marcio-pessoa/x6/Documents/ArduinoMegaSensorShield3_Fronte.jpg

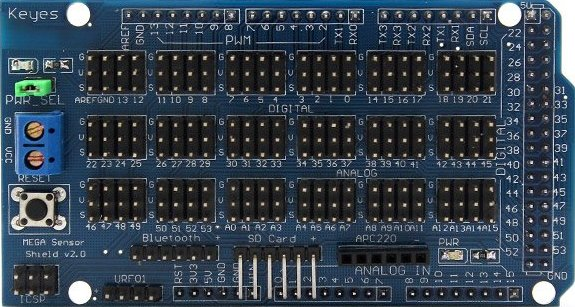
Documents/ArduinoMegaSensorShield3_Fronte.jpg
