marcio-pessoa/x6/Documents/download.jpg

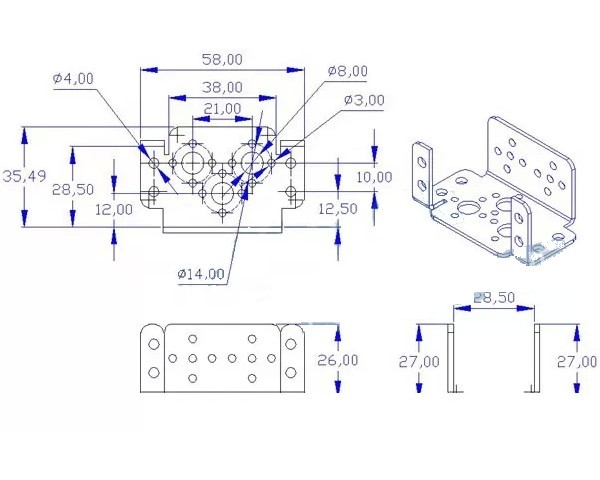
Documents/download.jpg
