marcio-pessoa/x6/Documents/Pictures/IMG_20151103_233049.jpg

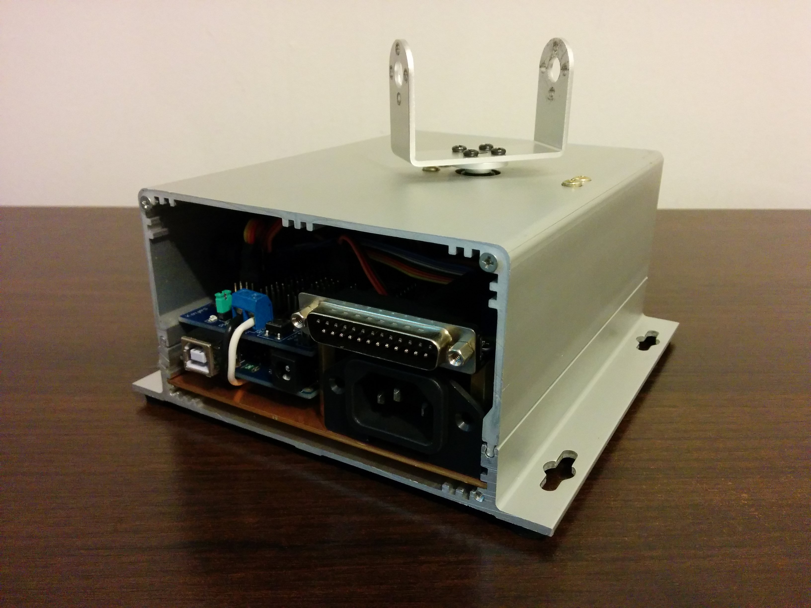
Documents/Pictures/IMG_20151103_233049.jpg
