marcio-pessoa/x6/Documents/Pictures/IMG_20151103_2321172.jpg

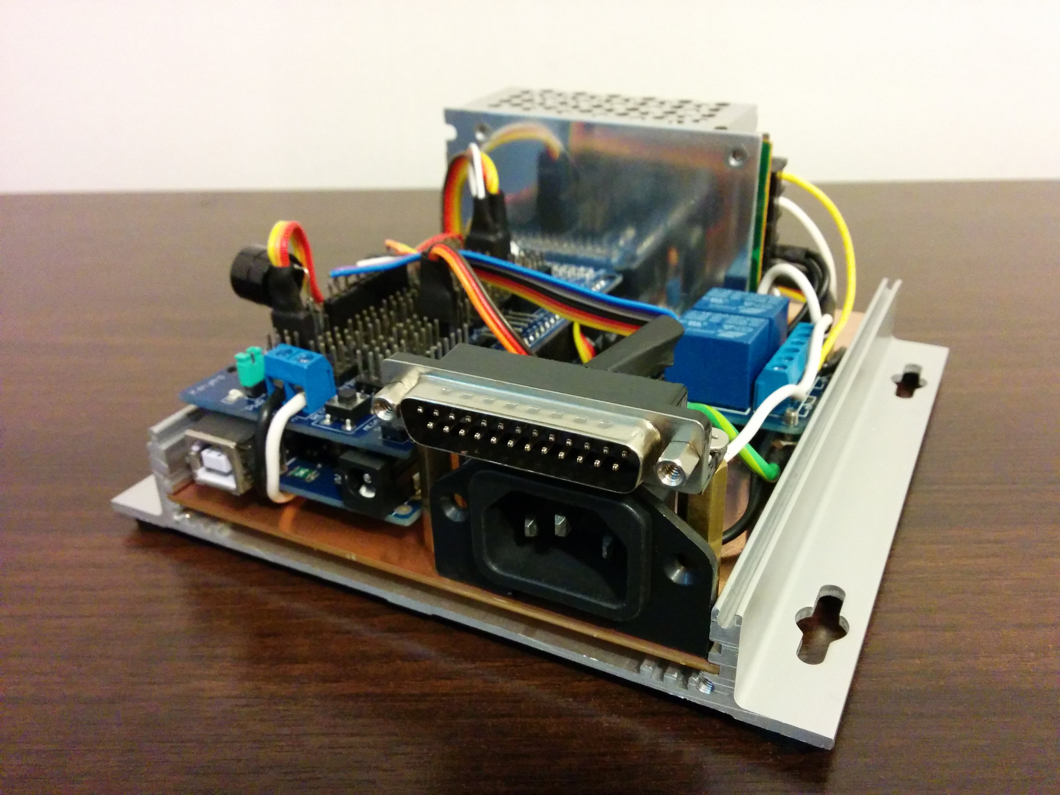
Documents/Pictures/IMG_20151103_2321172.jpg
