marcio-pessoa/x6/Documents/Pictures/x6-Mark-I-Live-demonstration.png

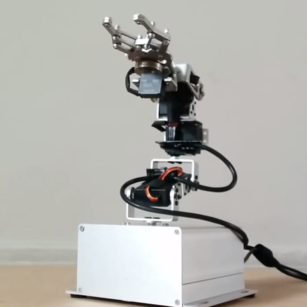
Documents/Pictures/x6-Mark-I-Live-demonstration.png
