marcio-pessoa/x6/Mechanics/Pictures/IMG_20181107_210936051.jpg

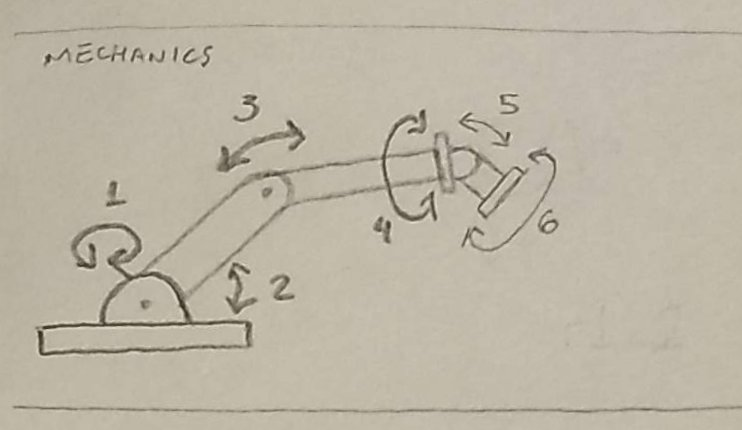
Mechanics/Pictures/IMG_20181107_210936051.jpg
