marcio-pessoa/x6/Mechanics/Pictures/IMG_20181107_211012699.jpg

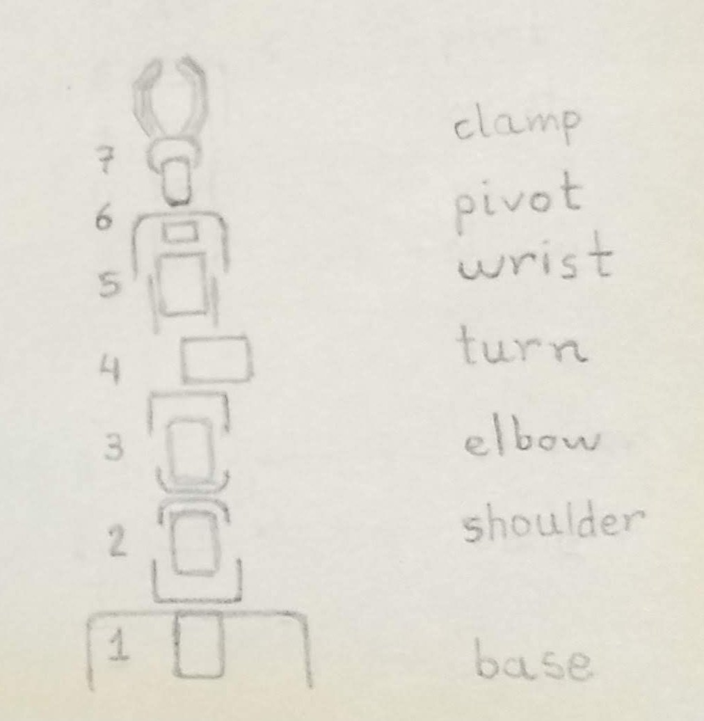
Mechanics/Pictures/IMG_20181107_211012699.jpg
