marcio-pessoa/x6/BOM.md

# BOM

x6 Mark I - Robotic Arm, Bill of materials

| Quant | Description | ID | Bought | Delivered  | Unit | Charge | Taxes | Cost |
|---|---|---|---|---|---|---|---|---|
| 1 | Case | 171177929049 | 2014-07-08 | 2014-08-29 | each |  22.50 | 00.00 |  00.00 |
| 1 | Arduino_Mega_2560 | 121021001026454322 | 2012-10-21 | 2013-mm-dd | each |  24.20 | 00.00 |  00.00 |

- 1 x 2DOF Aluminum Short U bracket & Multifunction Bracket for Robot Servo Joint DIY
  - Technical specification
    - URL: <http://www.dx.com/p/250674>
  - Buy
    - Date: 29/01/2014 02:34
    - Cost: USD 6.94
    - DX item ID: 140128001031940204
  - Delivery
    - Date: 2014-mm-dd
  - Install

- HJ S3315D 15kg Torque Metal gear Digital Servo for Robot Truck R/C Helicopter - Black
  - Technical specification
    - URL: <http://www.dx.com/p/193284>
  - Buy
    - Date: 29/01/2014 02:34
    - Cost: USD 11.97
    - DX item ID: 140128001031940204
  - Delivery
    - Date: 2014-mm-dd
  - Install

- Towerpro MG995 Metal Servo with Gears and Parts - Black
  - Technical specification
    - URL: <http://www.dx.com/p/20089>
  - Buy
    - Date: 18/07/2014 04:55
    - Cost: USD 7.71
    - DX item ID: 140717001098928788
  - Delivery
    - Date: 2014-mm-dd
  - Install

- EMAX ES3104 Metal Analog Servo with Gears and Parts - Black (4.8~6.0V)
  - Technical specification
    - URL: <http://www.dx.com/p/226837>
  - Buy
    - Date: 17/07/2014 04:22
    - Cost: USD 9.22
    - DX item ID: 140716001092373509
  - Delivery
    - Date: 2014-mm-dd
  - Install

- DIY PC817 2-CH 5V Relay Module w/ Optocoupler Extension Board - Blue
  - Technical specification
    - URL: <http://www.dx.com/p/290132>
  - Buy
    - Date: 22/04/2014 12:23
    - Cost: USD 3.70
    - DX item ID: 140422001040513986
  - Delivery
    - Date: 2014-mm-dd
  - Install

- 5V 3.8A Regulated Switching Power Supply - Silver
  - Technical specification
    - URL: <http://www.dx.com/p/145841>
  - Buy
    - Date: Tue, Oct 1, 2013 at 1:47 PM
    - Cost: USD 7.99
    - DX item ID: 131001001096463012
  - Delivery
    - Date: 2014-mm-dd
  - Install
- 3 x 2 Metal U Holders + 2 Mount Brackets for R/C Helicopter - Silver
  - Technical specification
    - URL: <http://www.dx.com/p/193069>
  - Buy
    - Date: Tue, Oct 1, 2013 at 3:45 PM
    - Cost: USD 9.45
    - DX item ID: 131001001097613313
  - Delivery
    - Date: 2014-mm-dd
  - Install
- DAGU VA2 Aluminum Alloy Robot Arm Clamp w/ Two Metal Gear Motors for Arduino - Silver White + Black-206374
  - Technical specification
    - URL: <http://www.dx.com/p/206374>
  - Buy
    - Date: Thu, Jul 4, 2013 at 2:35 PM
    - Cost: USD 52.10
    - DX item ID: 130704001062929240
  - Delivery
    - Date: 2013-mm-dd
  - Install
- 3 x HJ S3315D 15kg Torque Metal gear Digital Servo for Robot Truck R/C Helicopter - Black
  - Technical specification
    - URL: <http://www.dx.com/p/193284>
  - Buy
    - Date: Tue, Oct 1, 2013 at 3:45 PM
    - Cost: USD 29.01
    - DX item ID: 131001001097613313
  - Delivery
    - Date: 2014-mm-dd
  - Install

- MEGA Sensor Shield V2.0 Dedicated Sensor Expansion Board for Arduino
  - Technical specification
    - URL: <http://www.dx.com/p/120479>
  - Buy
    - Date: Fri, Oct 4, 2013 at 2:14 PM
    - Cost: USD 7.90
    - DX item ID: 131004001035335339
  - Delivery
    - Date: 2014-mm-dd
  - Install

- 2 Metal U Holders + 2 Round Servo Mount Brackets w/ Screws for R/C Helicopter - Silver-193069
  - Technical specification
    - URL: <http://www.dx.com/p/250674>
  - Buy
    - Date: Sun, Feb 23, 2014 at 8:38 PM
    - Cost: USD 4.12
    - DX item ID: 140223001030732822
  - Delivery
    - Date: 2014-mm-dd
  - Install

- 2DOF Aluminum Short U bracket & Multifunction Bracket for Robot Servo Joint DIY-250674
  - Technical specification
    - URL: <http://www.dx.com/p/250674>
  - Buy
    - Date: Tue, Jan 28, 2014 at 4:35 PM
    - Cost: USD 6.94
    - DX item ID: 140128001031940204
  - Delivery
    - Date: 2014-mm-dd
  - Install

- Stainless Steel threaded bar M4
  - Technical specification
    - URL: <http://www.ebay.com/itm/304-Stainless-Steel-Threaded-Rod-Bar-Studding-Allthread-M3-M4-M5-M6-M8-M10-M12-/321966375658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>
  - Buy
    - Date: Wed, Oct 26, 2016 at 7:36 AM
    - Cost: USD 2.43 (GBP 1.99)
    - eBay item ID: 321966375658
  - Delivery
    - Date: 2017-01-dd
  - Install

- Acorn nut M4
  - Technical specification
    - URL: <http://www.ebay.com/itm/Qty-10-M4-x-0-7mm-Pitch-Dome-Nuts-Acorn-Hex-Cap-Nuts-304-A2-Stainless-Steel-/182271690592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>
  - Buy
    - Date: Wed, Oct 26, 2016 at 7:41 AM
    - Cost: USD 1.62
    - eBay item ID: 182271690592
  - Delivery
    - Date: 2016-12-dd
  - Install

- Active Buzzer Long Continous Beep Speaker 5V
  - Technical specification
    - URL: <http://rover.ebay.com/rover/0/e11400.m1842.l5919/7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,ext=ext>
  - Buy
    - Date: Tue, Jan 5, 2016 at 6:23 AM
    - Cost: USD 0.99
    - eBay item ID: 361365119994
    - Delivery: 2016-mm-dd
  - Install

- Micro cooling fan DC 5V 0.1A 20mm
  - Technical specification
    - URL: <http://rover.ebay.com/rover/0/e11400.m1842.l5919/7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>
  - Buy
    - Date: Wed, Sep 7, 2016 at 8:19 PM
    - Cost: USD 1.6884054 (GBP 3.96 / 3)
    - eBay item ID: 271969912680
    - Delivery: 2016-mm-dd
  - Install

Currency: USD

International IOF: 6.38%
Domestic IOF: 0.38%

Total cost: $210.4784054
