marcio-pessoa/x6/(commit log)

2017-10-29 Arduino code
2017-10-29 Electronic schematics
    [Fan speed control.sch, db25.sch, x6.sch]
2018-01-25 Update 'BOM.md'
